slider2828/Standalone-DIY-ESP32-Thermal-Pressure-Tire-Camera-Sensor/FInal Tire Sender Enclosure/flip_latch_revBI.stl

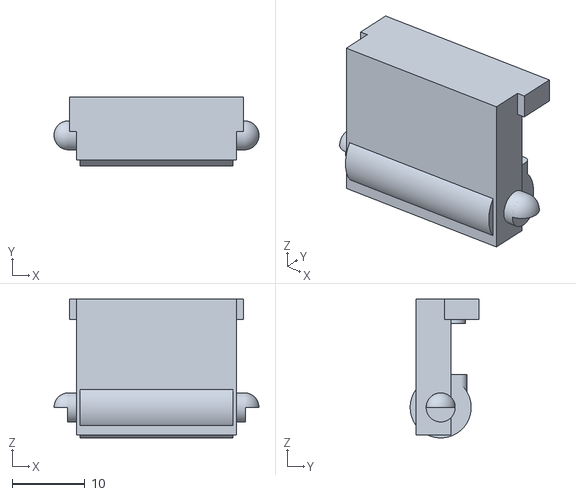
[picture p1: CAD file, 2026-10-20]
FInal Tire Sender Enclosure/flip_latch_revBI.stl
28.2 x 9.45 x 19.1
