slider2828/Standalone-DIY-ESP32-Thermal-Pressure-Tire-Camera-Sensor/Final Touch Screen Enclosure/waveshare_esp32_s3_4_3_s13_ratchet_hinge_ss12f15_switch_raised_to_connector_height_back.stl

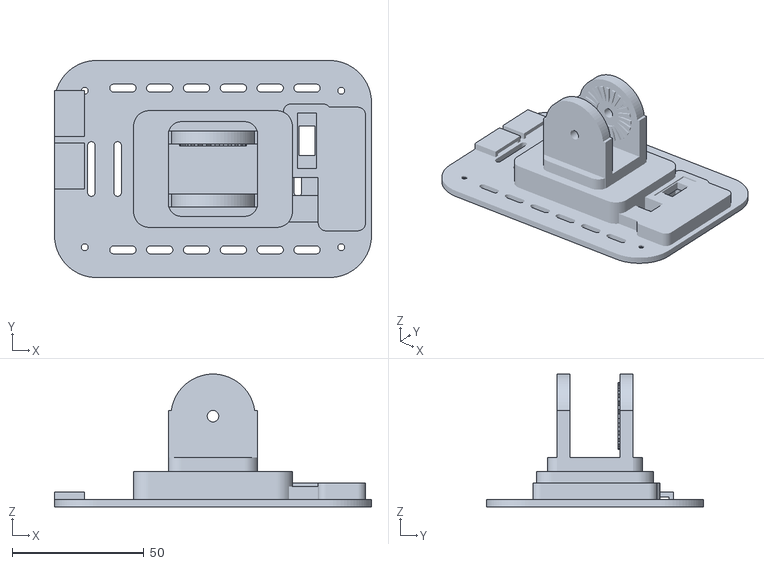
[picture p2: CAD file, 2026-10-20]
Final Touch Screen Enclosure/waveshare_esp32_s3_4_3_s13_ratchet_hinge_ss12f15_switch_raised_to_connector_height_back.stl
120.5 x 82.5 x 50.5
