slider2828/Standalone-DIY-ESP32-Thermal-Pressure-Tire-Camera-Sensor/FInal Tire Sender Enclosure/tire_sender_body_revBI.stl

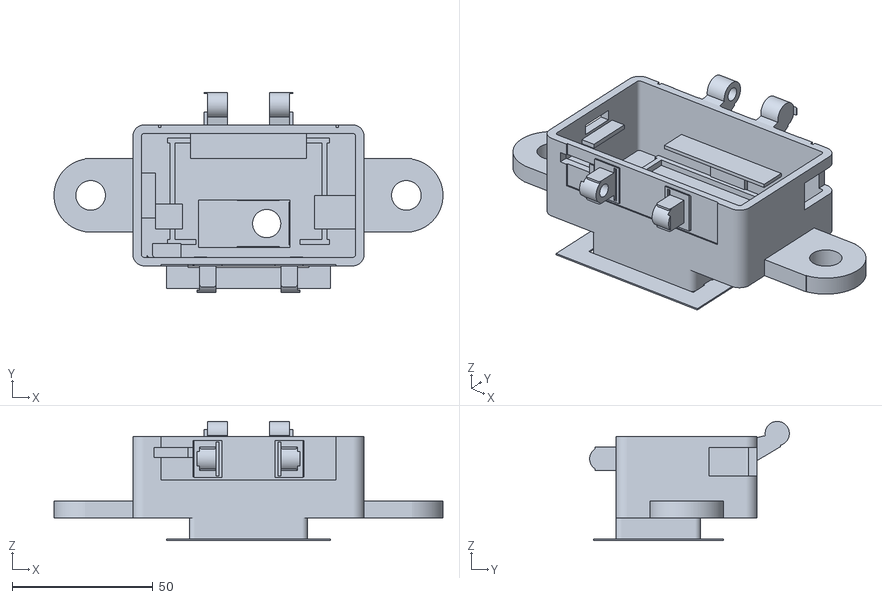
[picture p3: CAD file, 2026-10-20]
FInal Tire Sender Enclosure/tire_sender_body_revBI.stl
138.0 x 70.9 x 42.3
