slider2828/Standalone-DIY-ESP32-Thermal-Pressure-Tire-Camera-Sensor/Final Touch Screen Enclosure/TireTemp_Waveshare4.3_VentFrame_Final.3mf

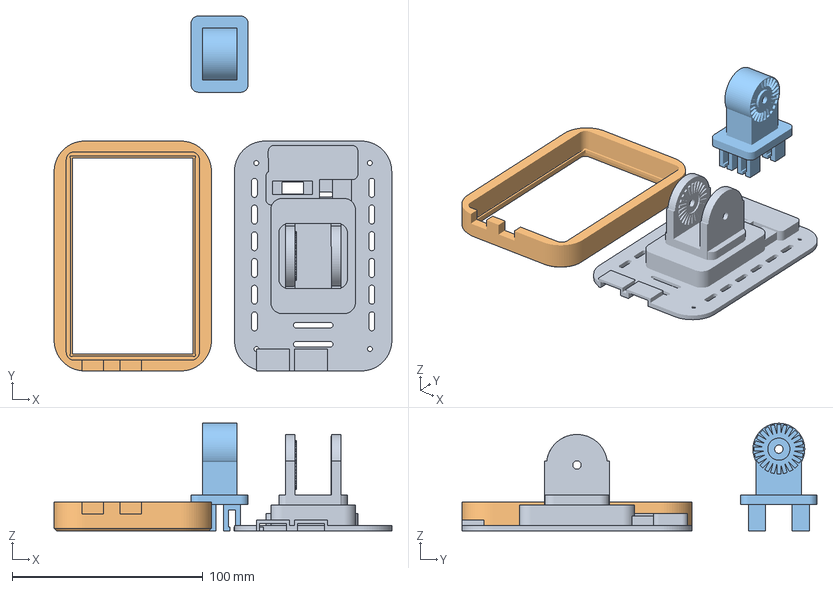
[picture p4: CAD file, 2026-10-20]
Final Touch Screen Enclosure/TireTemp_Waveshare4.3_VentFrame_Final.3mf
177.0 x 186.1 x 56.4 mm
waveshare_esp32_s3_4_3_s13_ratchet_hinge_ss12f15_switch_raised_to_connector_height_back.stl
waveshare_esp32_s3_4_3_s13_ratchet_hinge_usb_backrelief2mm_front_shell.stl
waveshare_esp32_s3_4_3_s13_ratchet_hinge_usb_backrelief2mm_vent_mount.stl
