slider2828/Standalone-DIY-ESP32-Thermal-Pressure-Tire-Camera-Sensor/FInal Tire Sender Enclosure/tire_sender_lid_revBI.stl

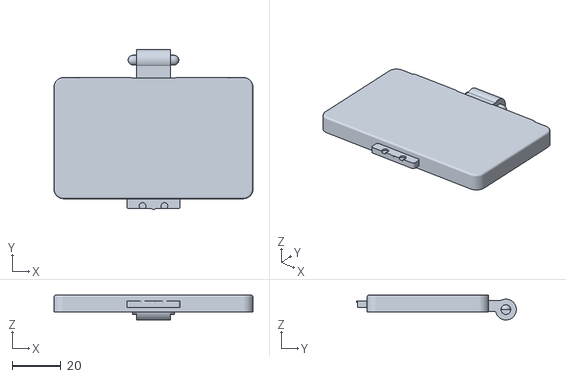
[picture p5: CAD file, 2026-10-20]
FInal Tire Sender Enclosure/tire_sender_lid_revBI.stl
82.0 x 65.8 x 10.3
