slider2828/Standalone-DIY-ESP32-Thermal-Pressure-Tire-Camera-Sensor/(list of files, cad)

Other CAD files:
Final Touch Screen Enclosure/waveshare_esp32_s3_4_3_s13_ratchet_hinge_ss12f15_rightside_usb_shrouded_screwstand_relief_back.stl
